Peter-004/Ranga/Altium/PCB1.step

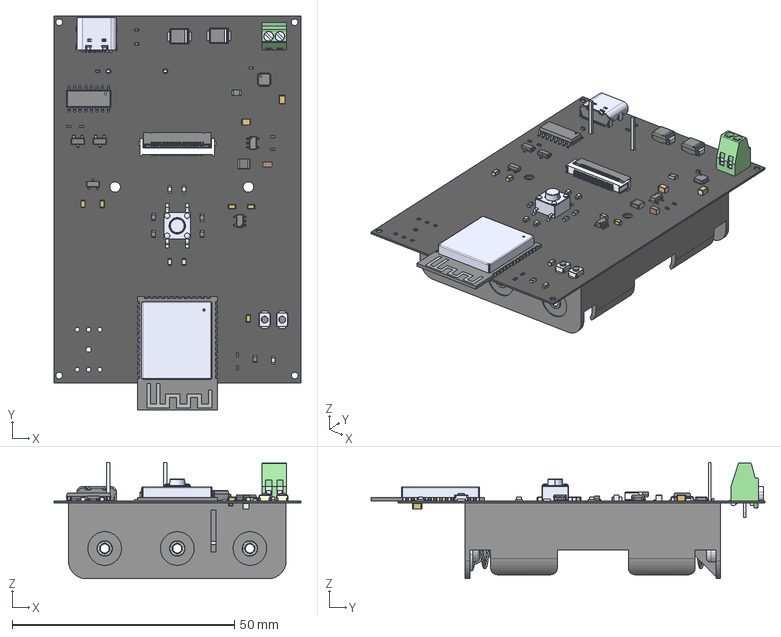
[picture p4: CAD file, 2026-11-07]
Altium/PCB1.step
55.5 x 88.7 x 26.2 mm
