Peter-004/Ranga/Altium/Ranga.pdf

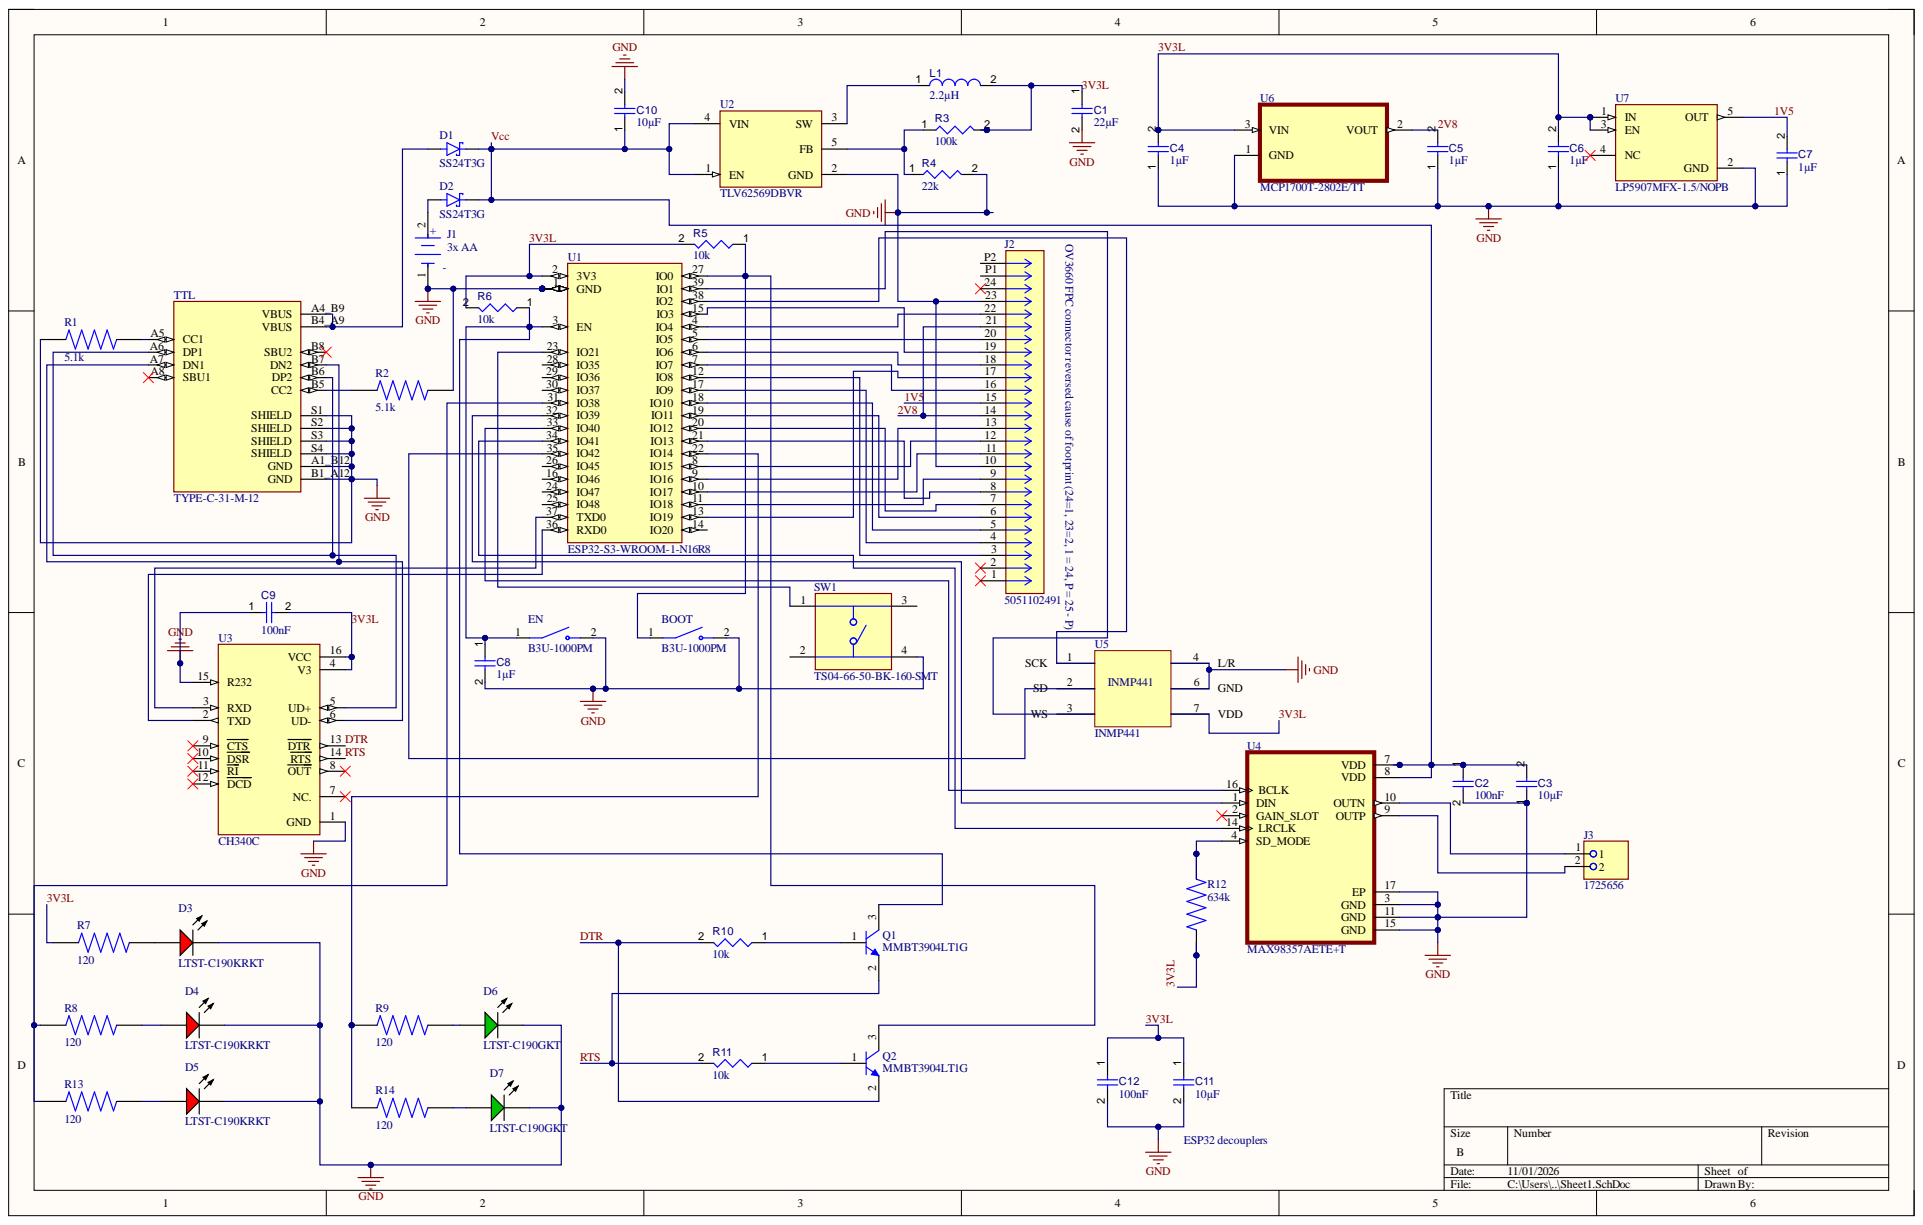
[picture p5: page 1]

OV3660 FPC connector reversed cause of footprint (24=1, 23=2, 1 = 24, P = 25 - P)

RXD0 36 | 5

Size B | Number | Revision

Date: 11/01/2026 | Sheet of
File: C:\Users\..\Sheet1.SchDoc | Drawn By:

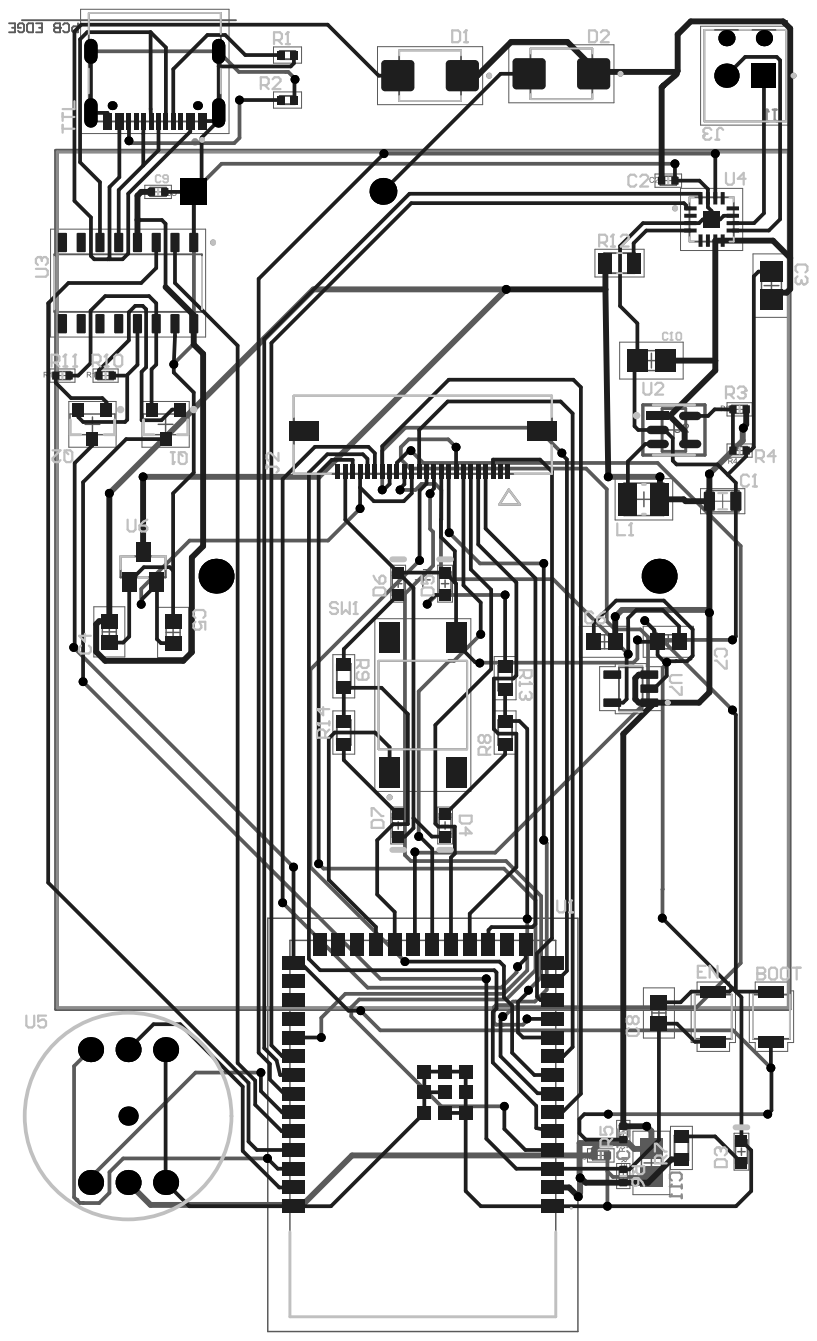
[picture p6: page 2]
