Peter-004/Ranga/(list of files, drawings)

Other design files:
Altium/PCB1.PcbDoc
Altium/Ranga.PrjPcb
Altium/Sheet1.SchDoc
