Peter-004/Ranga/Software/src/audio_data.h

#pragma once
#include <Arduino.h>

// Short two-tone boot chime, RAW 16-bit signed PCM, mono, 16000 Hz.
// Generated placeholder -- replace with your own sound using the
// ffmpeg command in the accompanying explanation. Format must stay
// the same: mono, 16-bit signed little-endian PCM, 16000 Hz.

#define AUDIO_DATA_SAMPLE_RATE 16000
#define AUDIO_DATA_SAMPLE_COUNT 5040

//This is just Nevada.mp3 (The famous recent Artemis II stuff) in hexadecimals...there's a lib for you to play this in the .ini file.
const uint8_t audioData[] PROGMEM = {
    0x00, 0x00, 0x17, 0x00, 0x59, 0x00, 0xB5, 0x00, 0x14, 0x01, 0x5B, 0x01, 0x71, 0x01, 0x45, 0x01,
    0xCF, 0x00, 0x13, 0x00, 0x27, 0xFF, 0x26, 0xFE, 0x38, 0xFD, 0x84, 0xFC, 0x30, 0xFC, 0x55, 0xFC,
    0xFE, 0xFC, 0x26, 0xFE, 0xB1, 0xFF, 0x74, 0x01, 0x3A, 0x03, 0xC5, 0x04, 0xDA, 0x05, 0x4A, 0x06,
    0xF6, 0x05, 0xDA, 0x04, 0x0A, 0x03, 0xB2, 0x00, 0x17, 0xFE, 0x86, 0xFB, 0x56, 0xF9, 0xD3, 0xF7,
    0x3B, 0xF7, 0xAF, 0xF7, 0x32, 0xF9, 0xA3, 0xFB, 0xC3, 0xFE, 0x37, 0x02, 0x97, 0x05, 0x76, 0x08,
    0x72, 0x0A, 0x41, 0x0B, 0xB9, 0x0A, 0xDB, 0x08, 0xD2, 0x05, 0xEE, 0x01, 0xA2, 0xFD, 0x6E, 0xF9,
    0xD8, 0xF5, 0x57, 0xF3, 0x45, 0xF2, 0xD3, 0xF2, 0xFF, 0xF4, 0x98, 0xF8, 0x39, 0xFD, 0x5C, 0x02,
    0x68, 0x07, 0xBE, 0x0B, 0xCF, 0x0E, 0x32, 0x10, 0xAC, 0x0F, 0x3D, 0x0D, 0x1F, 0x09, 0xC6, 0x03,
    0xCD, 0xFD, 0xE6, 0xF7, 0xCA, 0xF2, 0x1D, 0xEF, 0x5D, 0xED, 0xCE, 0xED, 0x73, 0xF0, 0x0A, 0xF5,
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
    0x78, 0xDD, 0x47, 0xDD, 0x32, 0xE1, 0xC1, 0xE8, 0x0F, 0xF3, 0xE6, 0xFE, 0xDD, 0x0A, 0x8C, 0x15,
    0xAE, 0x1D, 0x4F, 0x22, 0xE1, 0x22, 0x53, 0x1F, 0x10, 0x18, 0xF6, 0x0D, 0x35, 0x02, 0x32, 0xF6,
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
};

const uint32_t audioDataLength = sizeof(audioData);
